adarshsaraf/AUV/AUVMEC2020/AUVPCB.png

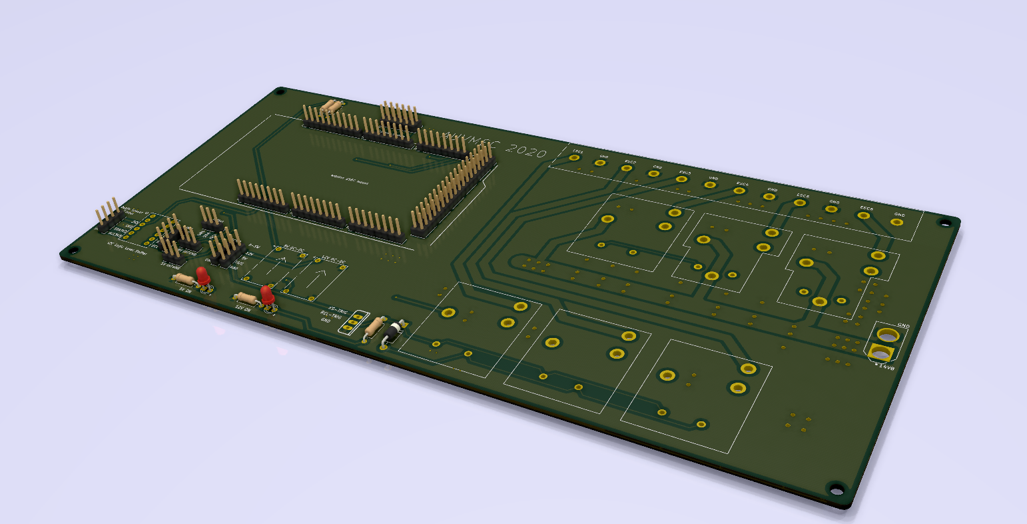
AUVMEC2020/AUVPCB.png
