adarshsaraf/AUV/AUVMEC2020/AUV_shirt design_EE.step

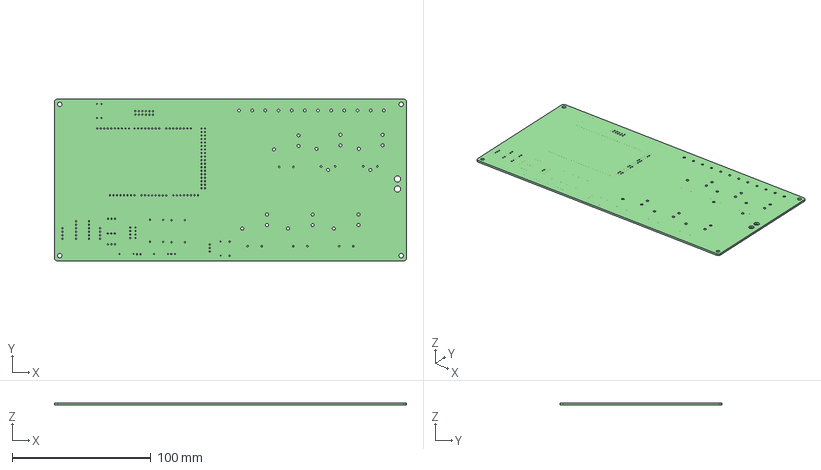
[picture p4: CAD file, 2023-05-08]
AUVMEC2020/AUV_shirt design_EE.step
254.0 x 116.8 x 1.60 mm
