adarshsaraf/AUV/(commit log)

2023-04-06 add stepper
2023-04-15 esc file
2023-05-08 Pavans files
    [AUVMEC2020-B_Cu.gbr, AUVMEC2020-B_Mask.gbr, AUVMEC2020-B_Paste.gbr, AUVMEC2020-B_SilkS.gbr, AUVMEC2020-Edge_Cuts.gbr, AUVMEC2020-F_Cu.gbr, AUVMEC2020-F_Mask.gbr, AUVMEC2020-F_Paste.gbr]
2023-05-10 tasks for battery
2023-05-18 old arduino test
2024-04-21 Create pcb designs
2024-04-21 Create kicad files
